IowaScaledEngineering/mss-crossover/mech/crossover-1x-blister-box v2.stl

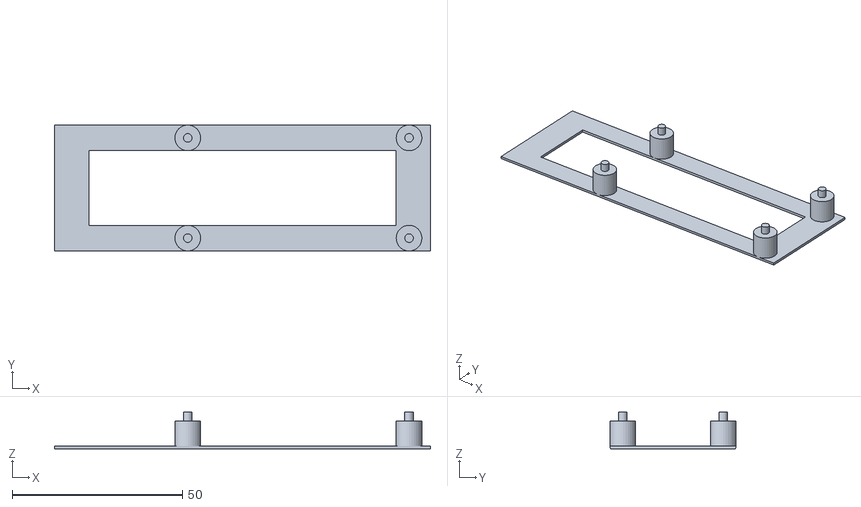
[picture p1: CAD file, 2024-08-07]
mech/crossover-1x-blister-box v2.stl
110.5 x 37.0 x 10.8
