IowaScaledEngineering/mss-crossover/pg/mss-crossover-array-v2.1-066dc88/mss-crossover.pdf

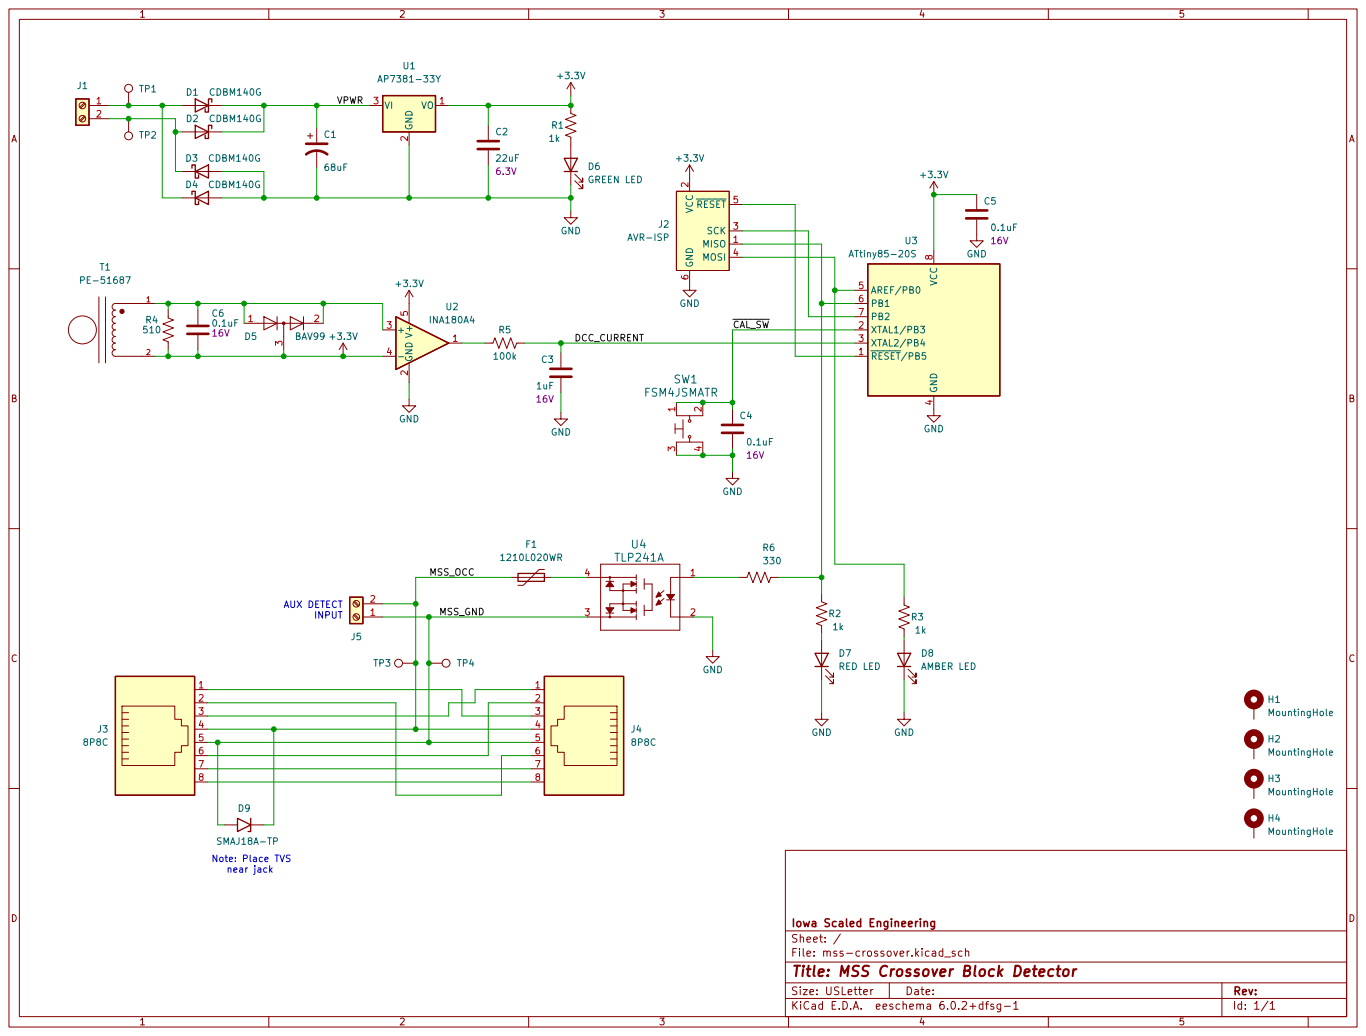
[picture p2: page 1]

2 SCK 3 MOSI 4 ~{RESET} 5 GND

INPUT Note: Place TVS
1k D9 SMAJ18A-TP

Iowa Scaled Engineering
File: mss-crossover.kicad_sch Sheet: /
Id: 1/1 Title: MSS Crossover Block Detector
