IowaScaledEngineering/mss-crossover/pg/mss-crossover-v2.0-48896b5/mss-crossover.pdf

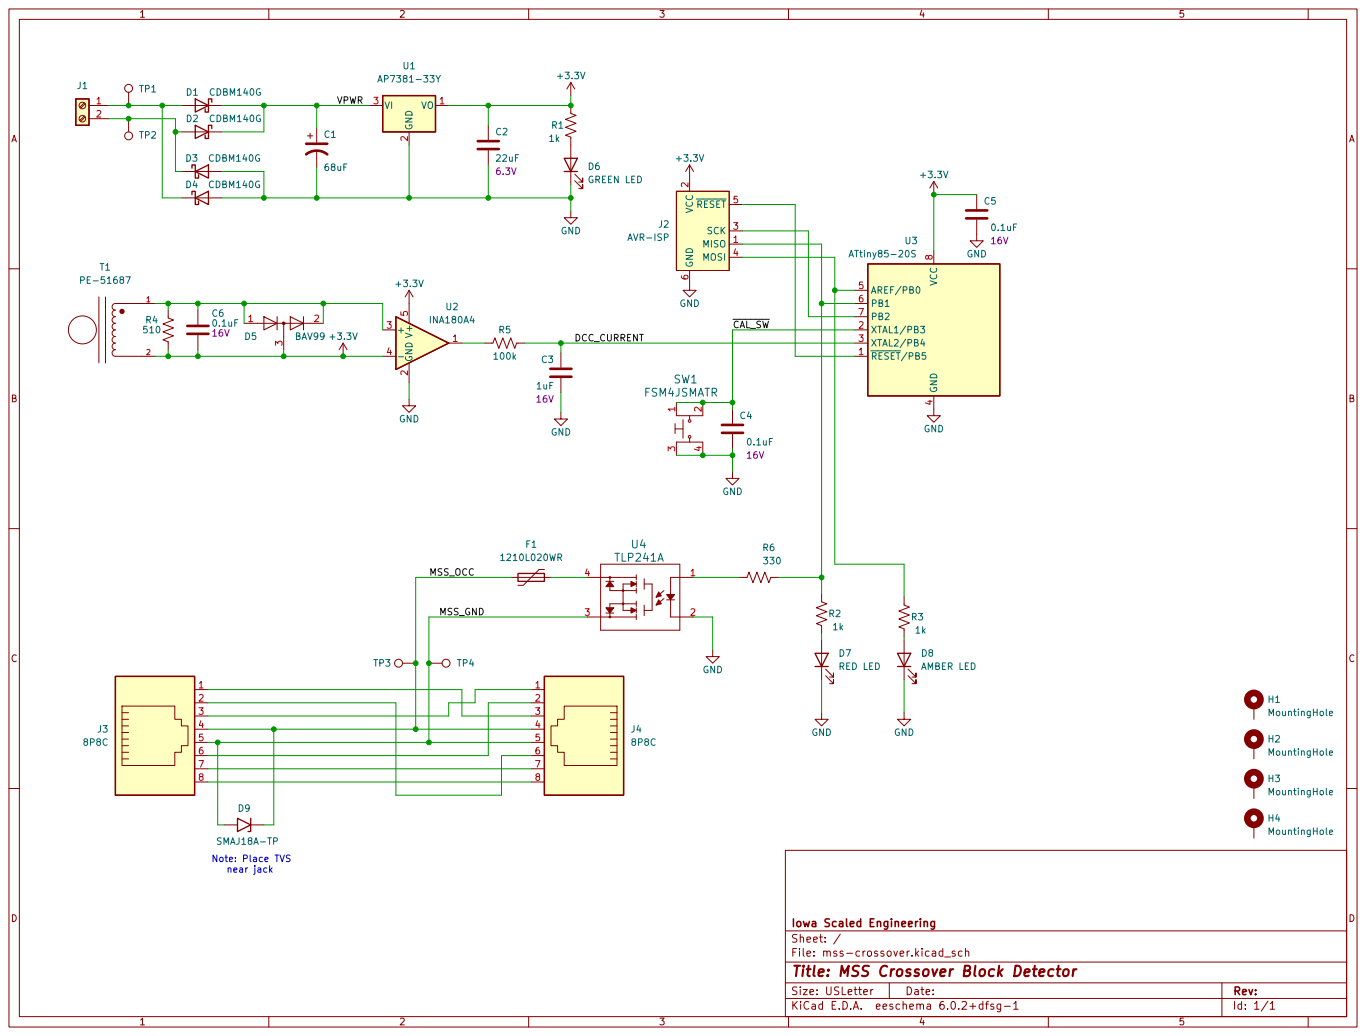
[picture p3: page 1]

2 SCK 3 MOSI 4 ~{RESET} 5 GND

Iowa Scaled Engineering GND

File: mss-crossover.kicad_sch Sheet: /
Id: 1/1 Title: MSS Crossover Block Detector
