IowaScaledEngineering/mss-crossover/pg/mss-crossover-v1.3-59efc50/mss-crossover.pdf

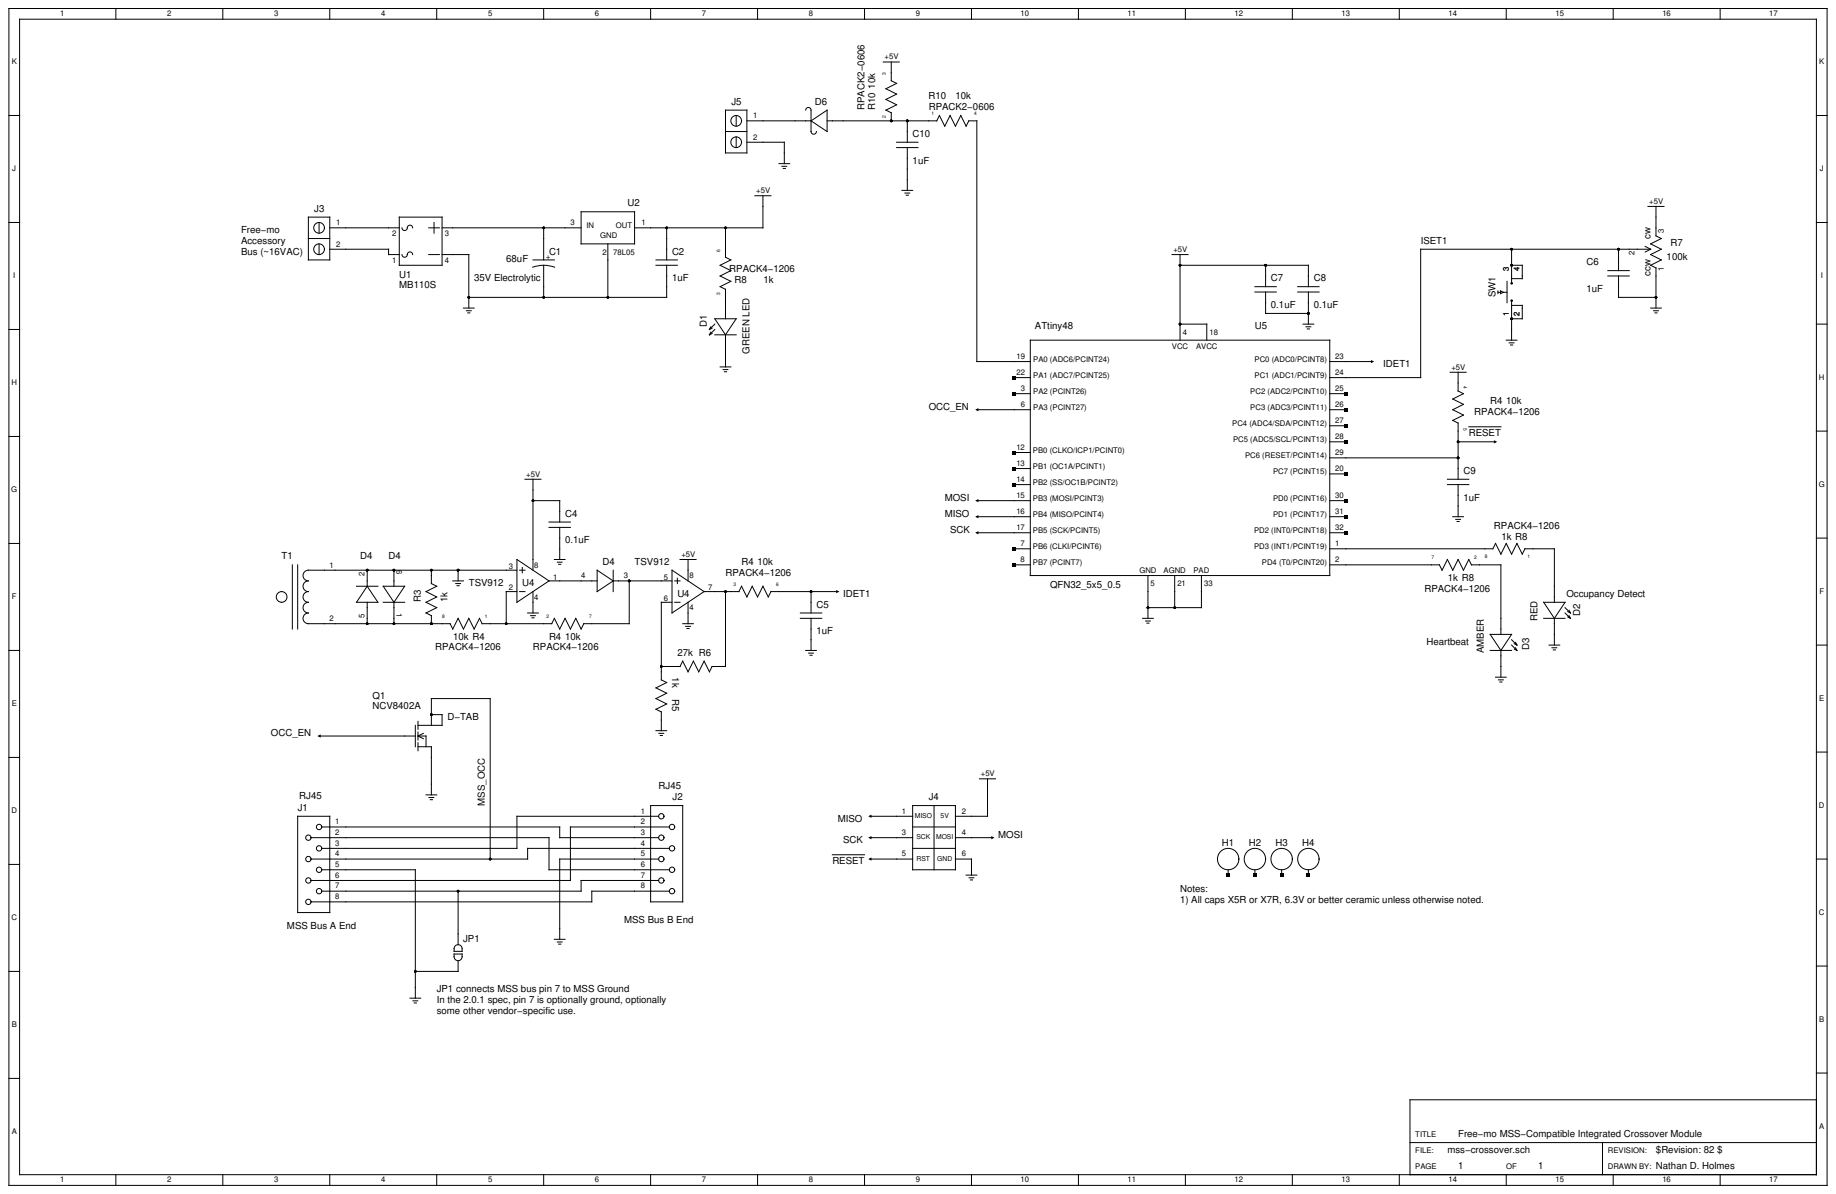
[picture p4: page 1]

Notes:
1) All caps X5R or X7R, 6.3V or better ceramic unless otherwise noted.

JP1 connects MSS bus pin 7 to MSS Ground
In the 2.0.1 spec, pin 7 is optionally ground, optionally
some other vendor−specific use.

Free−mo MSS−Compatible Integrated Crossover Module
mss−crossover.sch
