IowaScaledEngineering/mss-crossover/pg/mss-crossover-v1.2-c0949ba/mss-crossover-pcb.pdf

# mss-crossover.pcb

# 1. Table of Contents (This Page) Created on Thu Jun 1 21:09:37 2017

# 2. component 3. solder 4. outline 5. plated-drill 6. unplated-drill 7. componentmask 8. soldermask 9. topsilk 10. bottomsilk 11. toppaste 12. topassembly 13. bottomassembly 14. fab

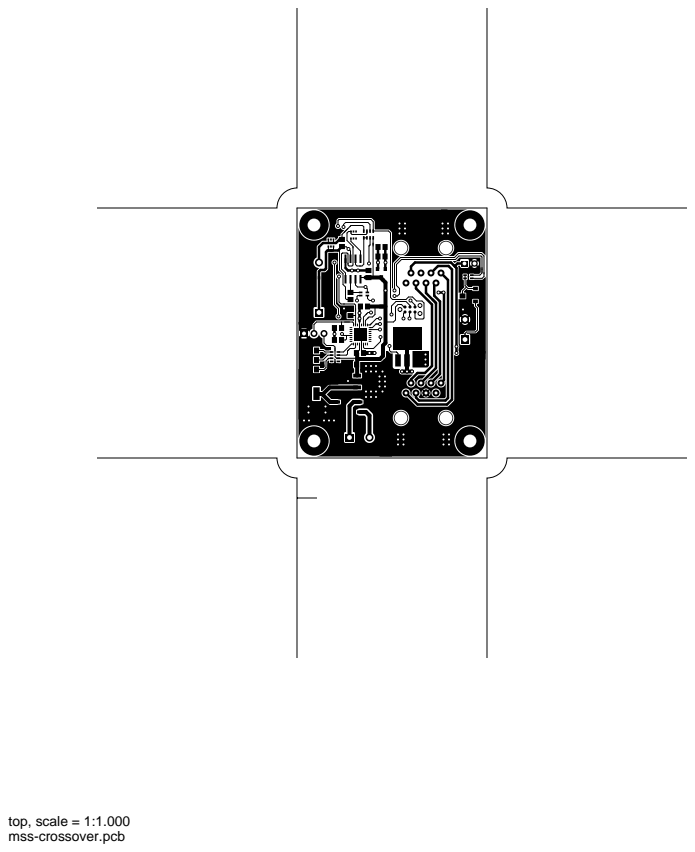
[picture p5: page 2]
top, scale = 1:1.000

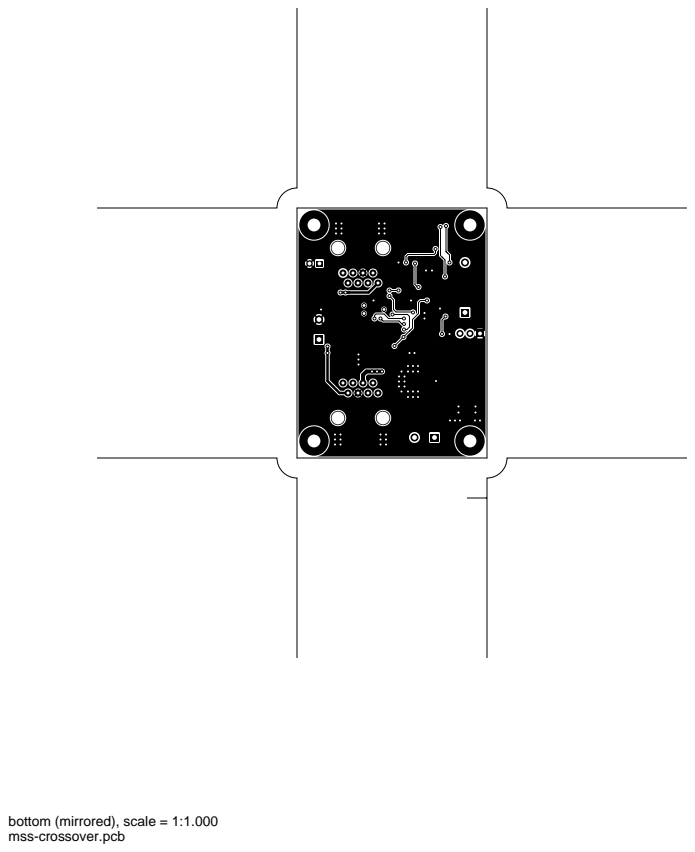
[picture p6: page 3]

bottom (mirrored), scale = 1:1.000

outline, scale = 1:1.000

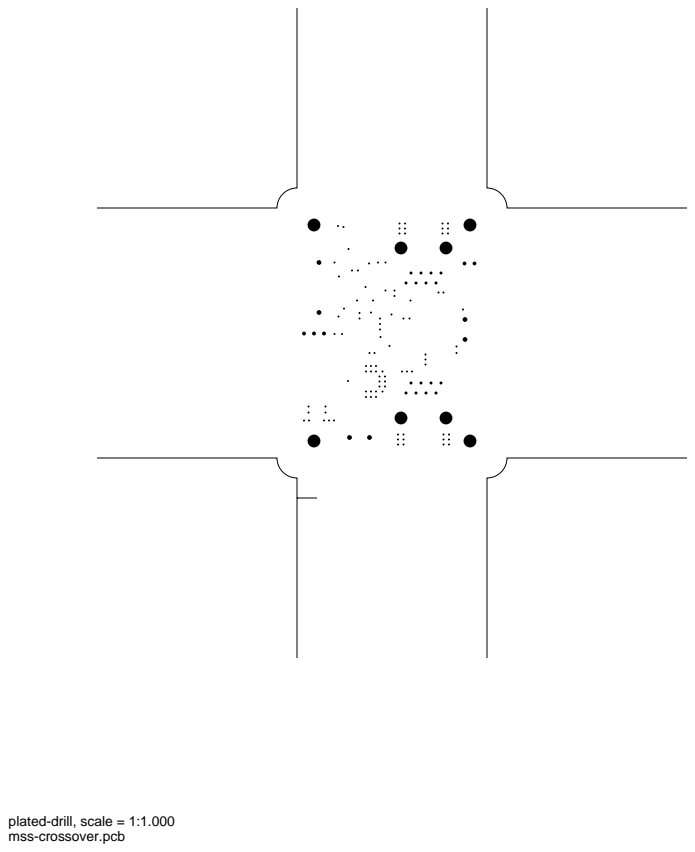
[picture p7: page 5]

plated-drill, scale = 1:1.000

unplated-drill, scale = 1:1.000

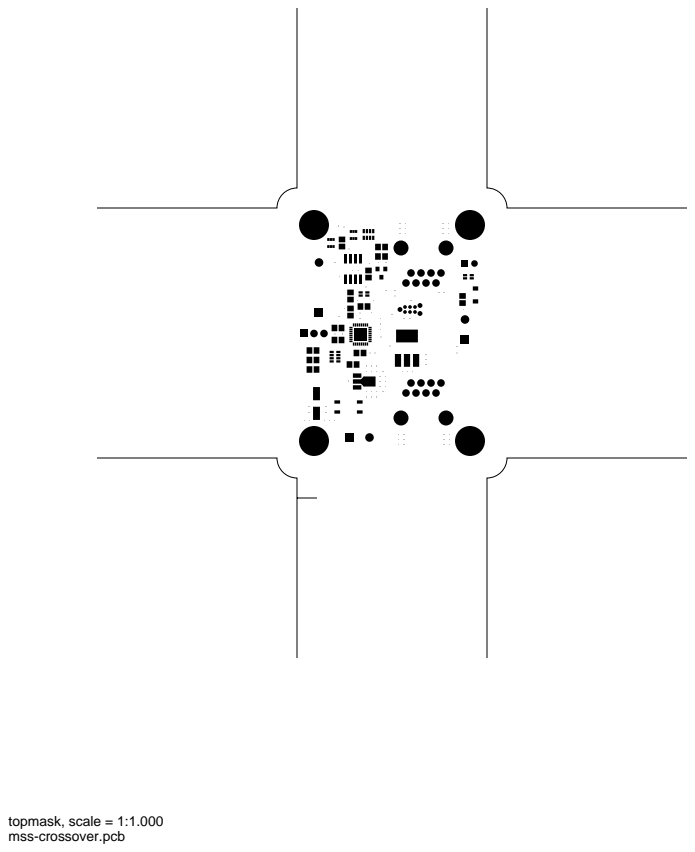
[picture p8: page 7]
topmask, scale = 1:1.000

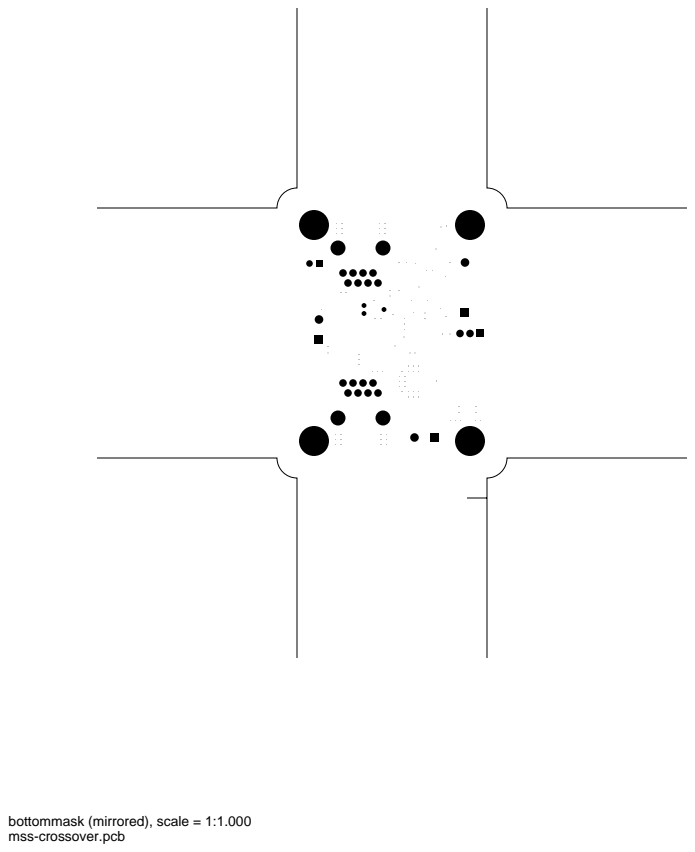
[picture p9: page 8]

bottommask (mirrored), scale = 1:1.000

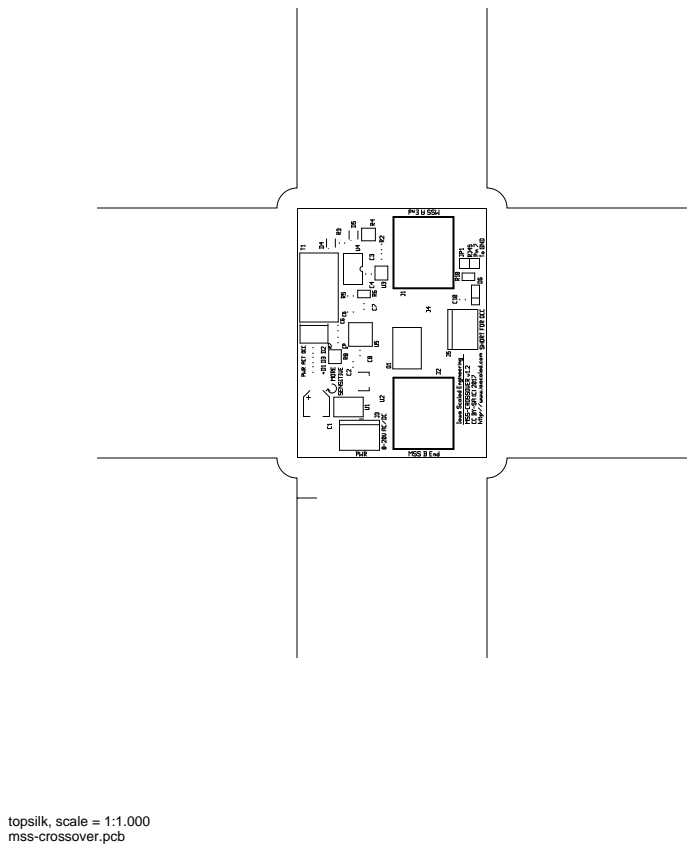
[picture p10: page 9]
topsilk, scale = 1:1.000

bottomsilk (mirrored), scale = 1:1.000

toppaste, scale = 1:1.000

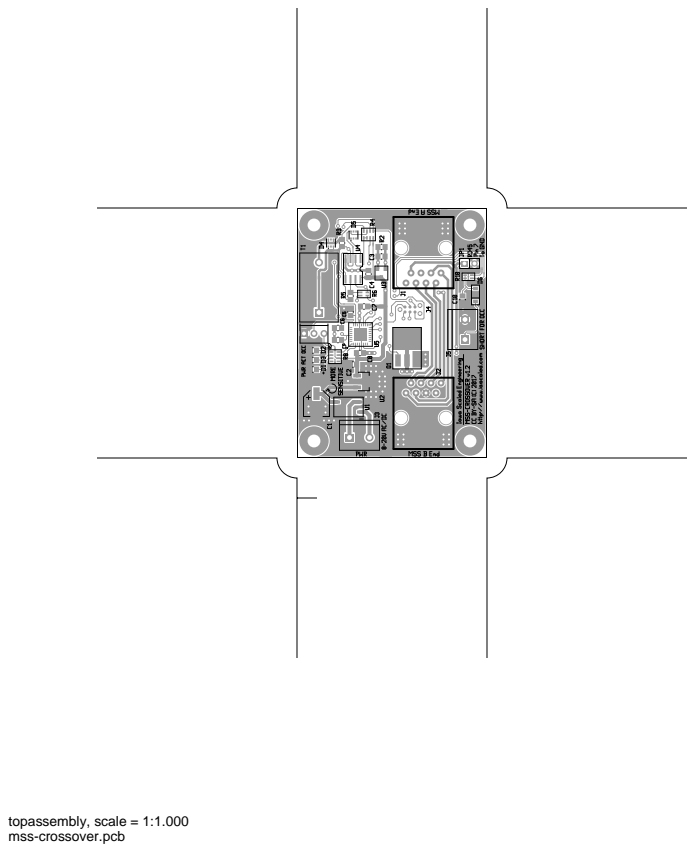
[picture p11: page 12]
topassembly, scale = 1:1.000

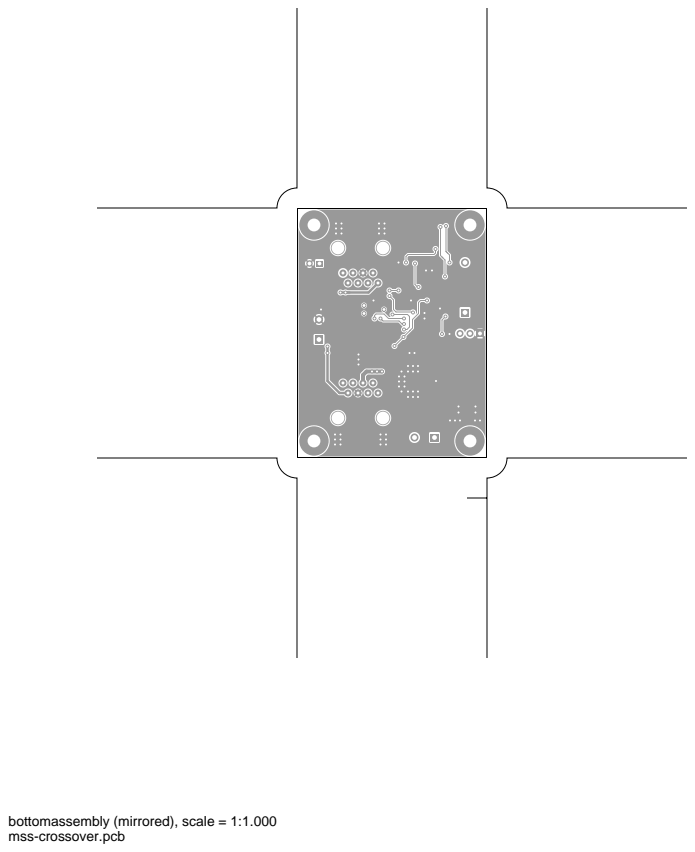
[picture p12: page 13]

bottomassembly (mirrored), scale = 1:1.000

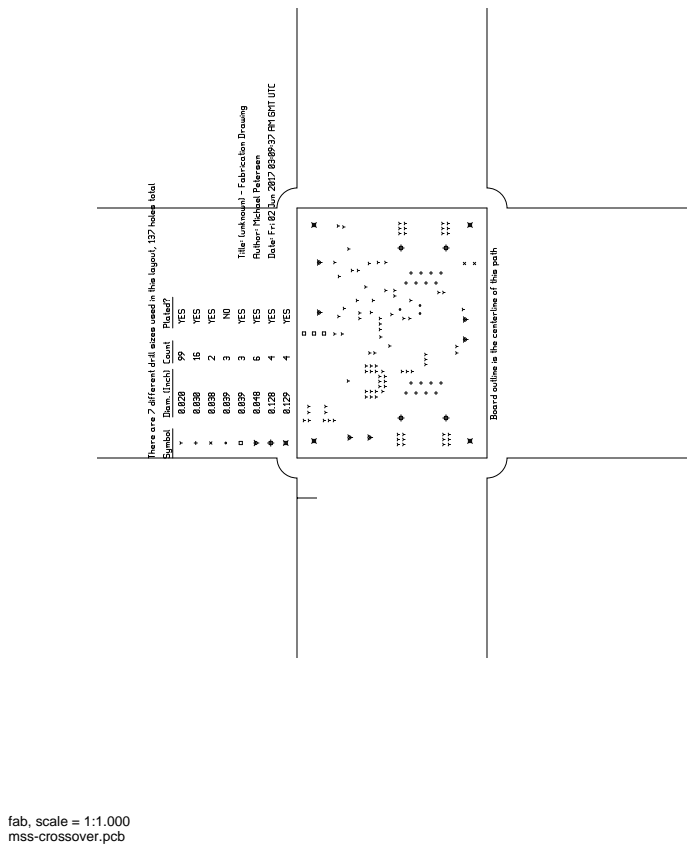
[picture p13: page 14]
fab, scale = 1:1.000
