IowaScaledEngineering/mss-crossover/pg/mss-crossover-v1.2-c0949ba/mss-crossover.pdf

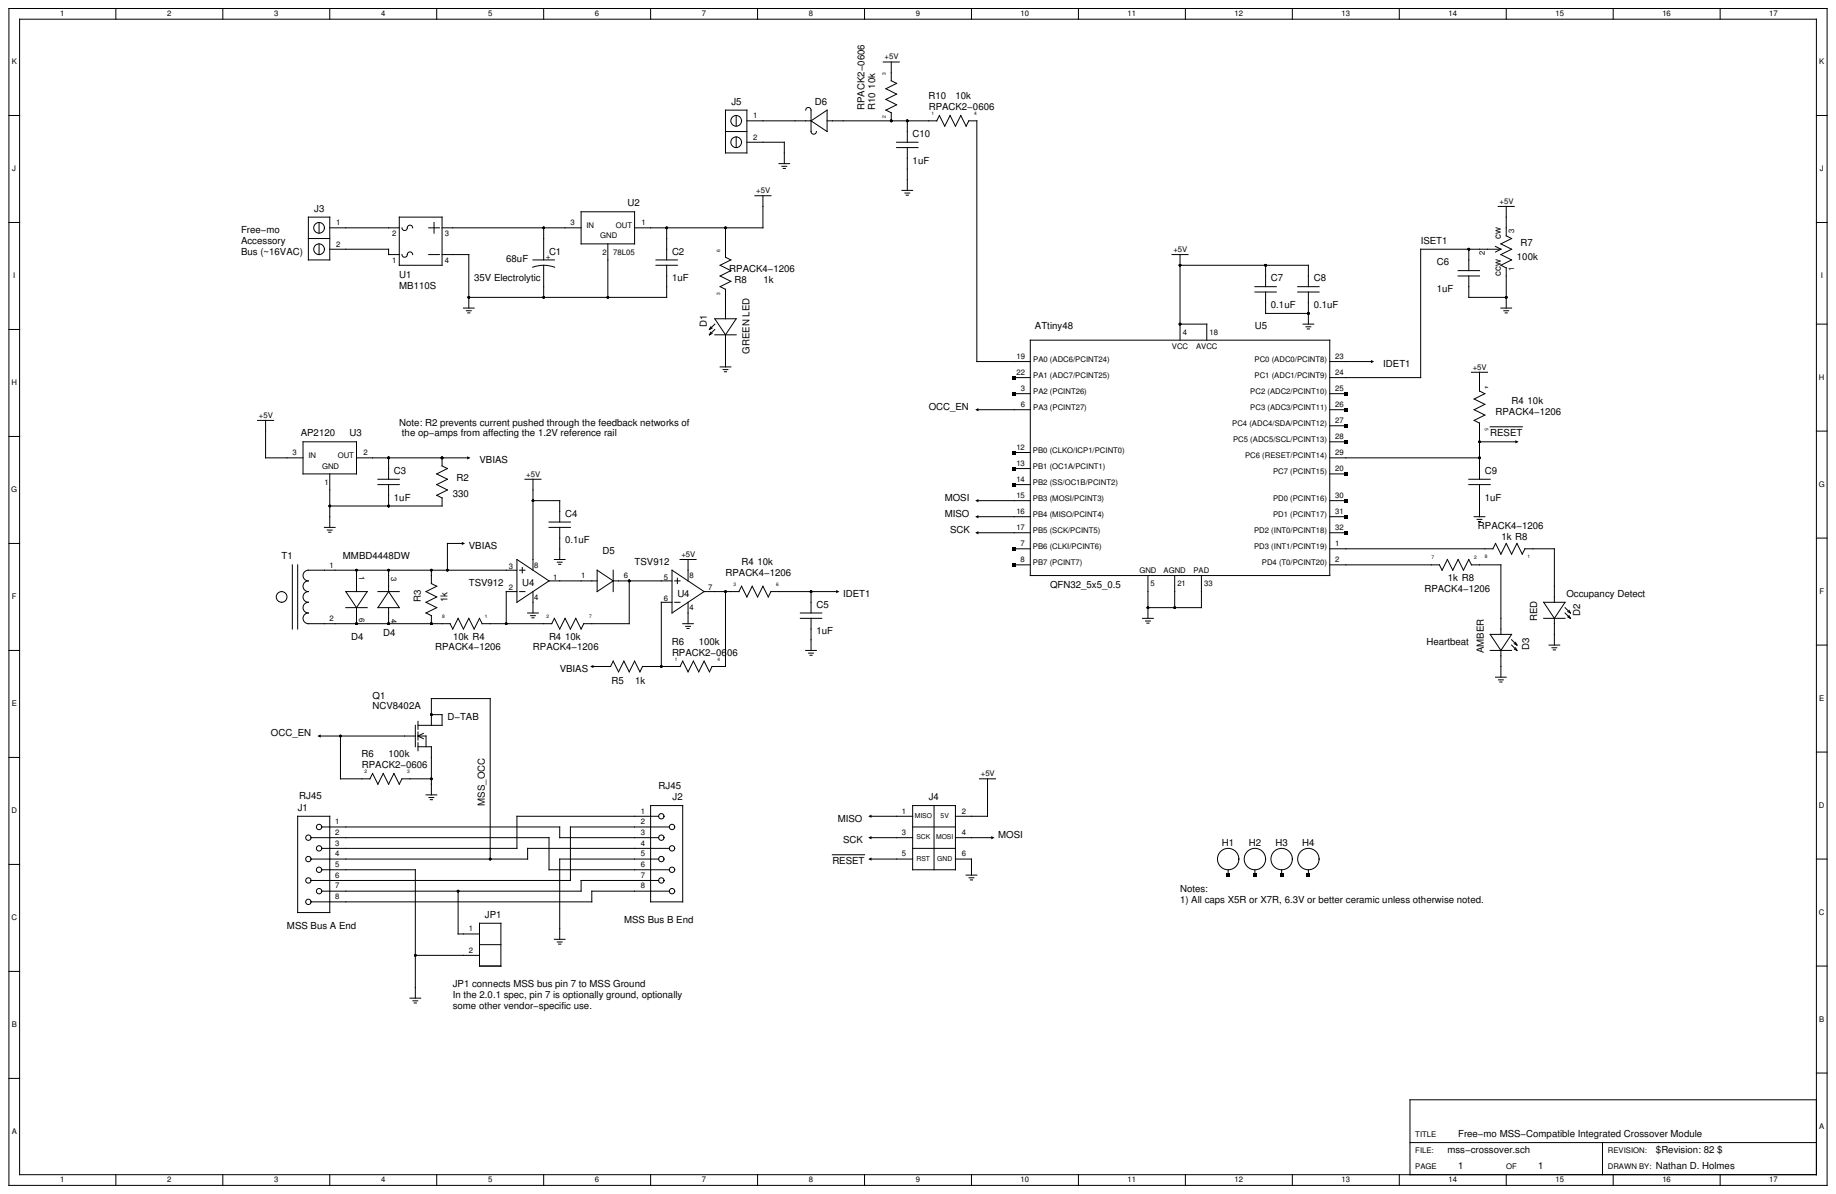
[picture p14: page 1]

Note: R2 prevents current pushed through the feedback networks of
the op−amps from affecting the 1.2V reference rail

Notes:
1) All caps X5R or X7R, 6.3V or better ceramic unless otherwise noted.

some other vendor−specific use. | JP1

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

Free−mo MSS−Compatible Integrated Crossover Module
mss−crossover.sch
