IowaScaledEngineering/mss-crossover/pg/mss-crossover-v1.0-68059cf/mss-crossover-pcb.pdf

# mss-crossover.pcb

# 1. Table of Contents (This Page) Created on Tue Nov 3 13:28:19 2015

# 2. component 3. solder 4. outline 5. plated-drill 6. unplated-drill 7. componentmask 8. soldermask 9. topsilk 10. bottomsilk 11. toppaste 12. topassembly 13. bottomassembly 14. fab

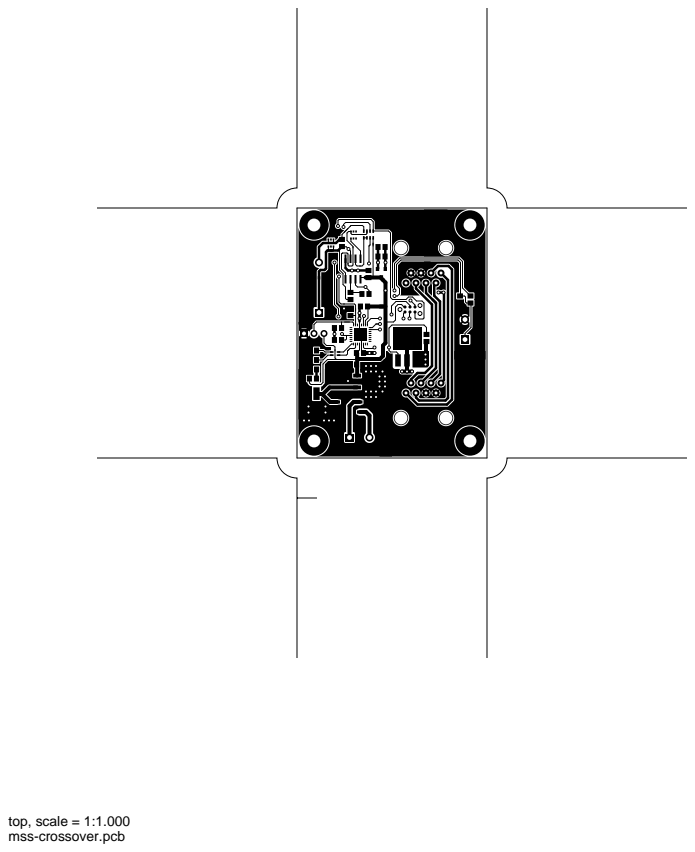
[picture p18: page 2]
top, scale = 1:1.000

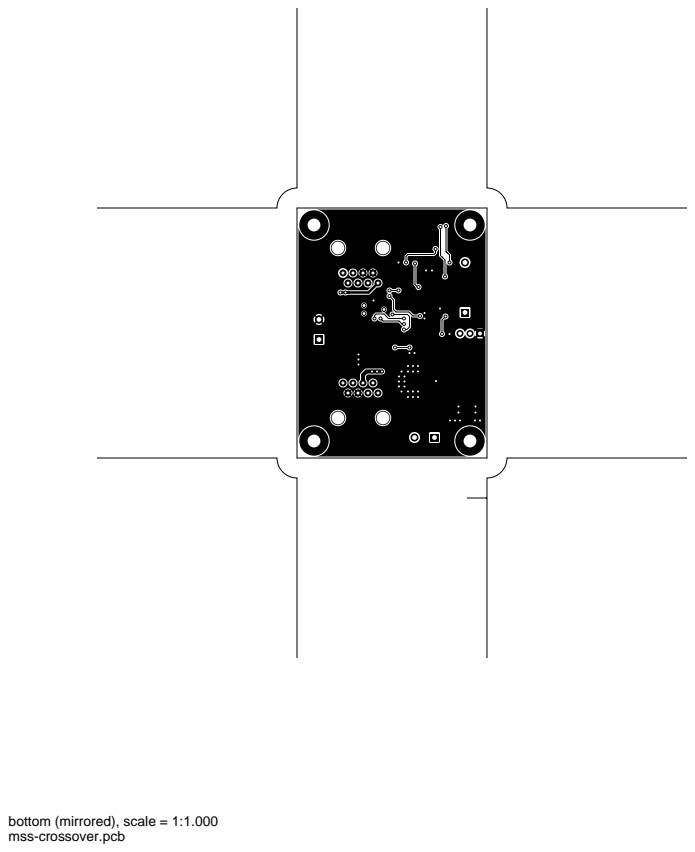
[picture p19: page 3]

bottom (mirrored), scale = 1:1.000

outline, scale = 1:1.000

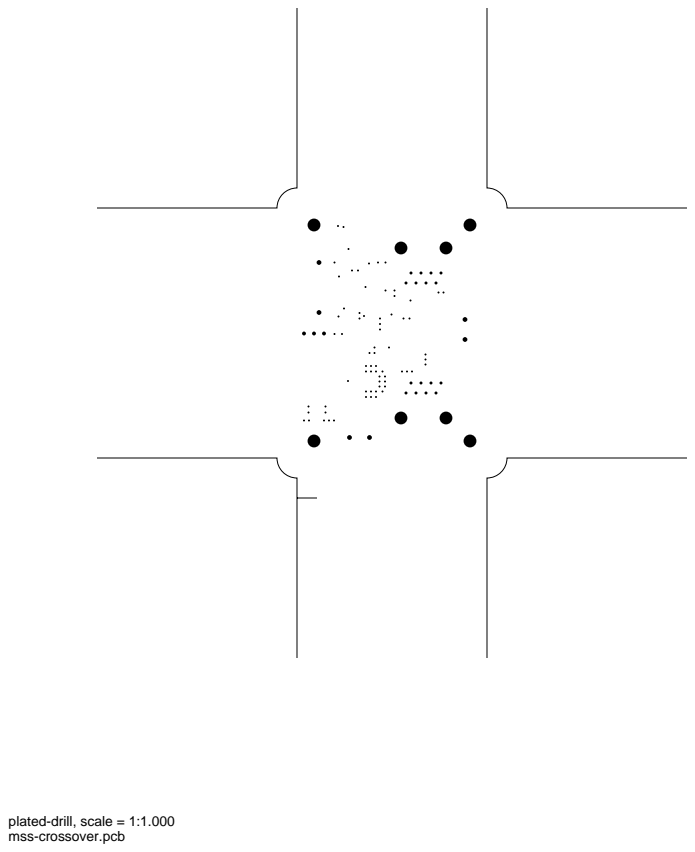
[picture p20: page 5]

plated-drill, scale = 1:1.000

unplated-drill, scale = 1:1.000

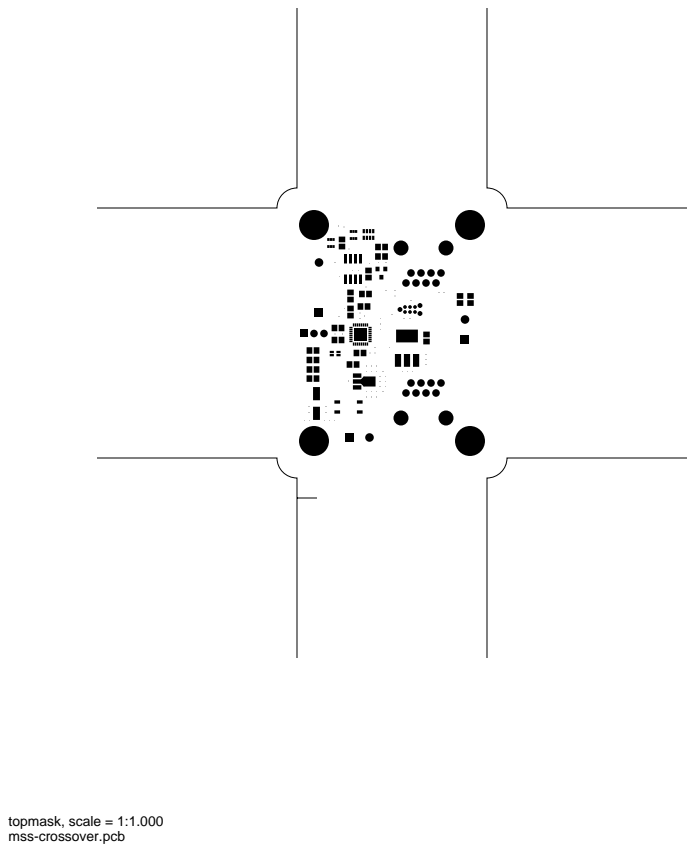
[picture p21: page 7]
topmask, scale = 1:1.000

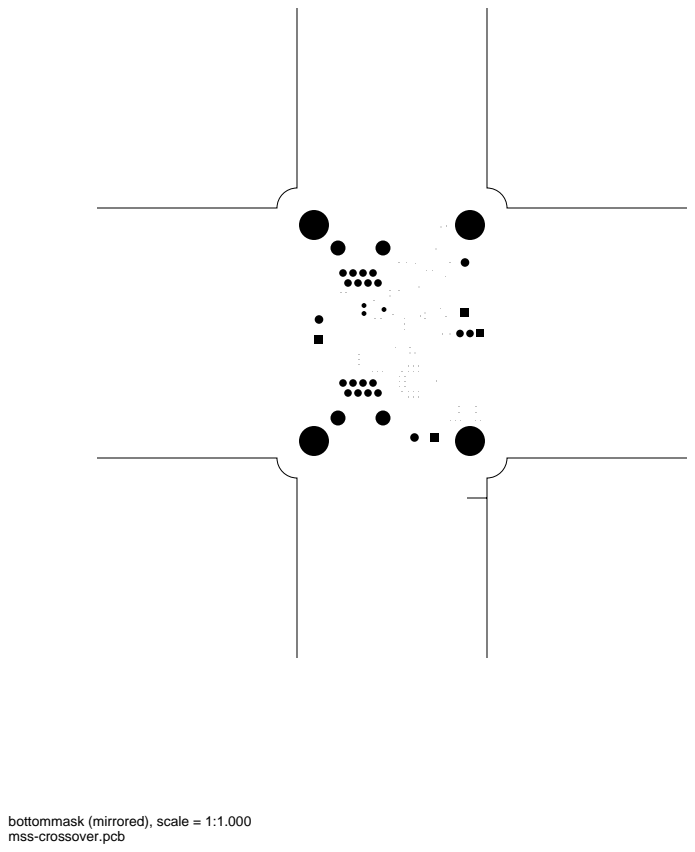
[picture p22: page 8]

bottommask (mirrored), scale = 1:1.000

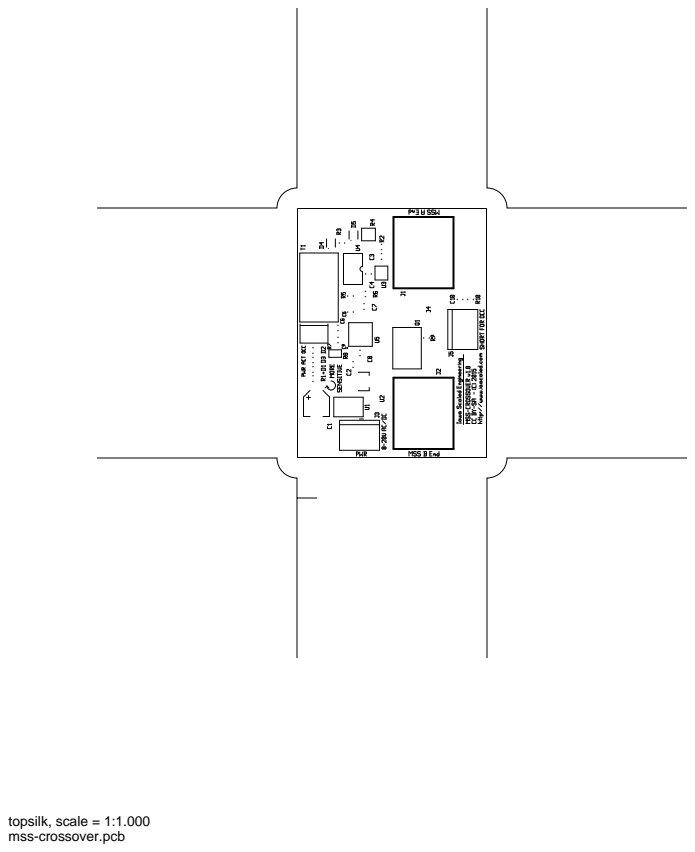
[picture p23: page 9]
topsilk, scale = 1:1.000

bottomsilk (mirrored), scale = 1:1.000

toppaste, scale = 1:1.000

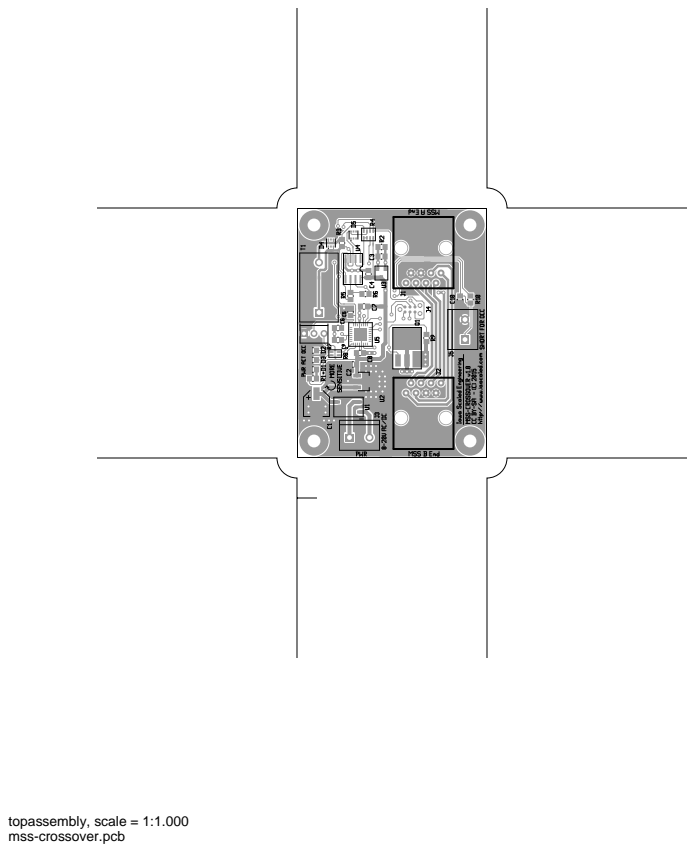
[picture p24: page 12]
topassembly, scale = 1:1.000

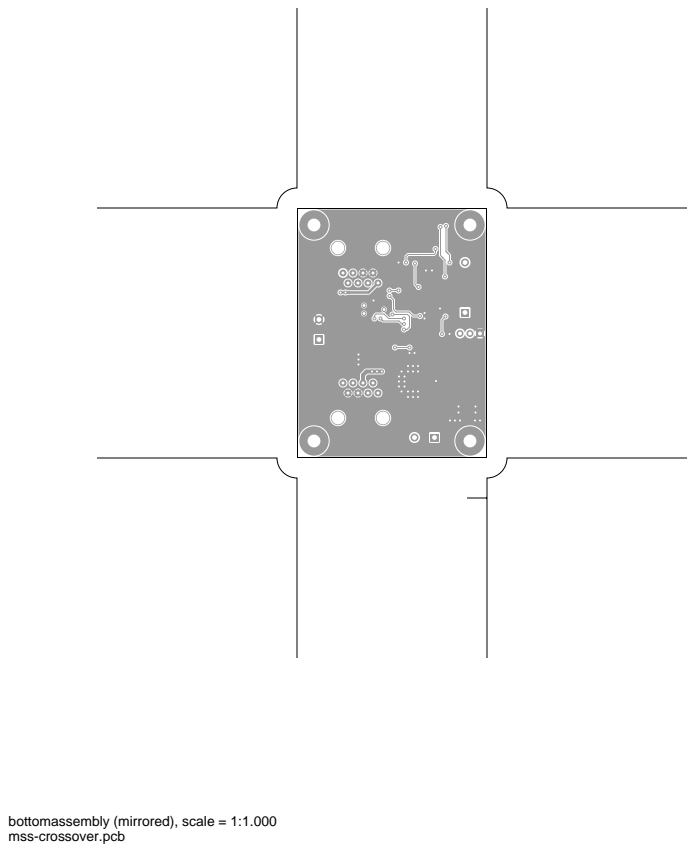
[picture p25: page 13]

bottomassembly (mirrored), scale = 1:1.000

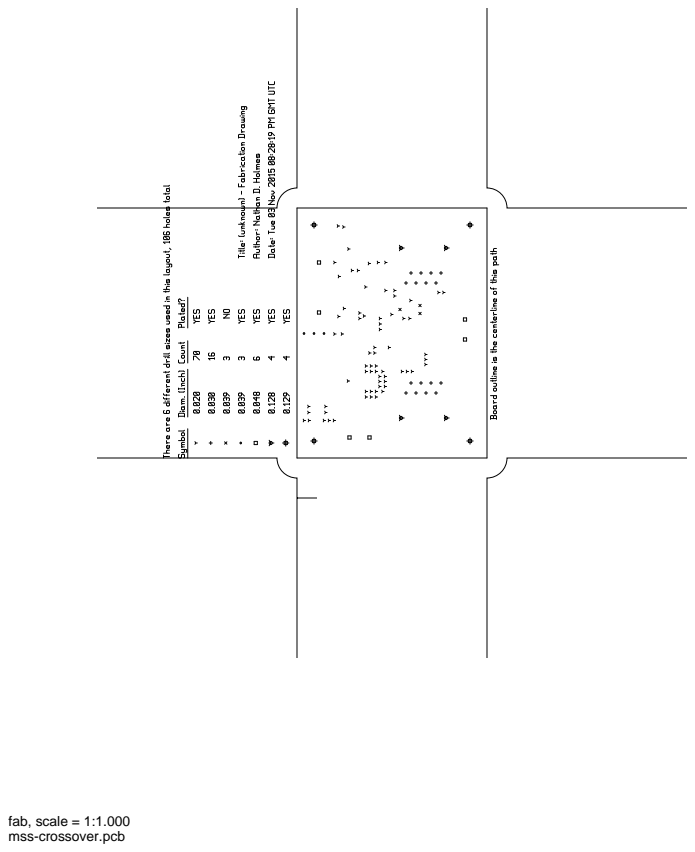
[picture p26: page 14]
fab, scale = 1:1.000
