IowaScaledEngineering/mss-crossover/kicad/mss-crossover/mss-crossover.kicad_pcb

## KiCad design kicad/mss-crossover/mss-crossover.kicad_pcb (2024-05-26)

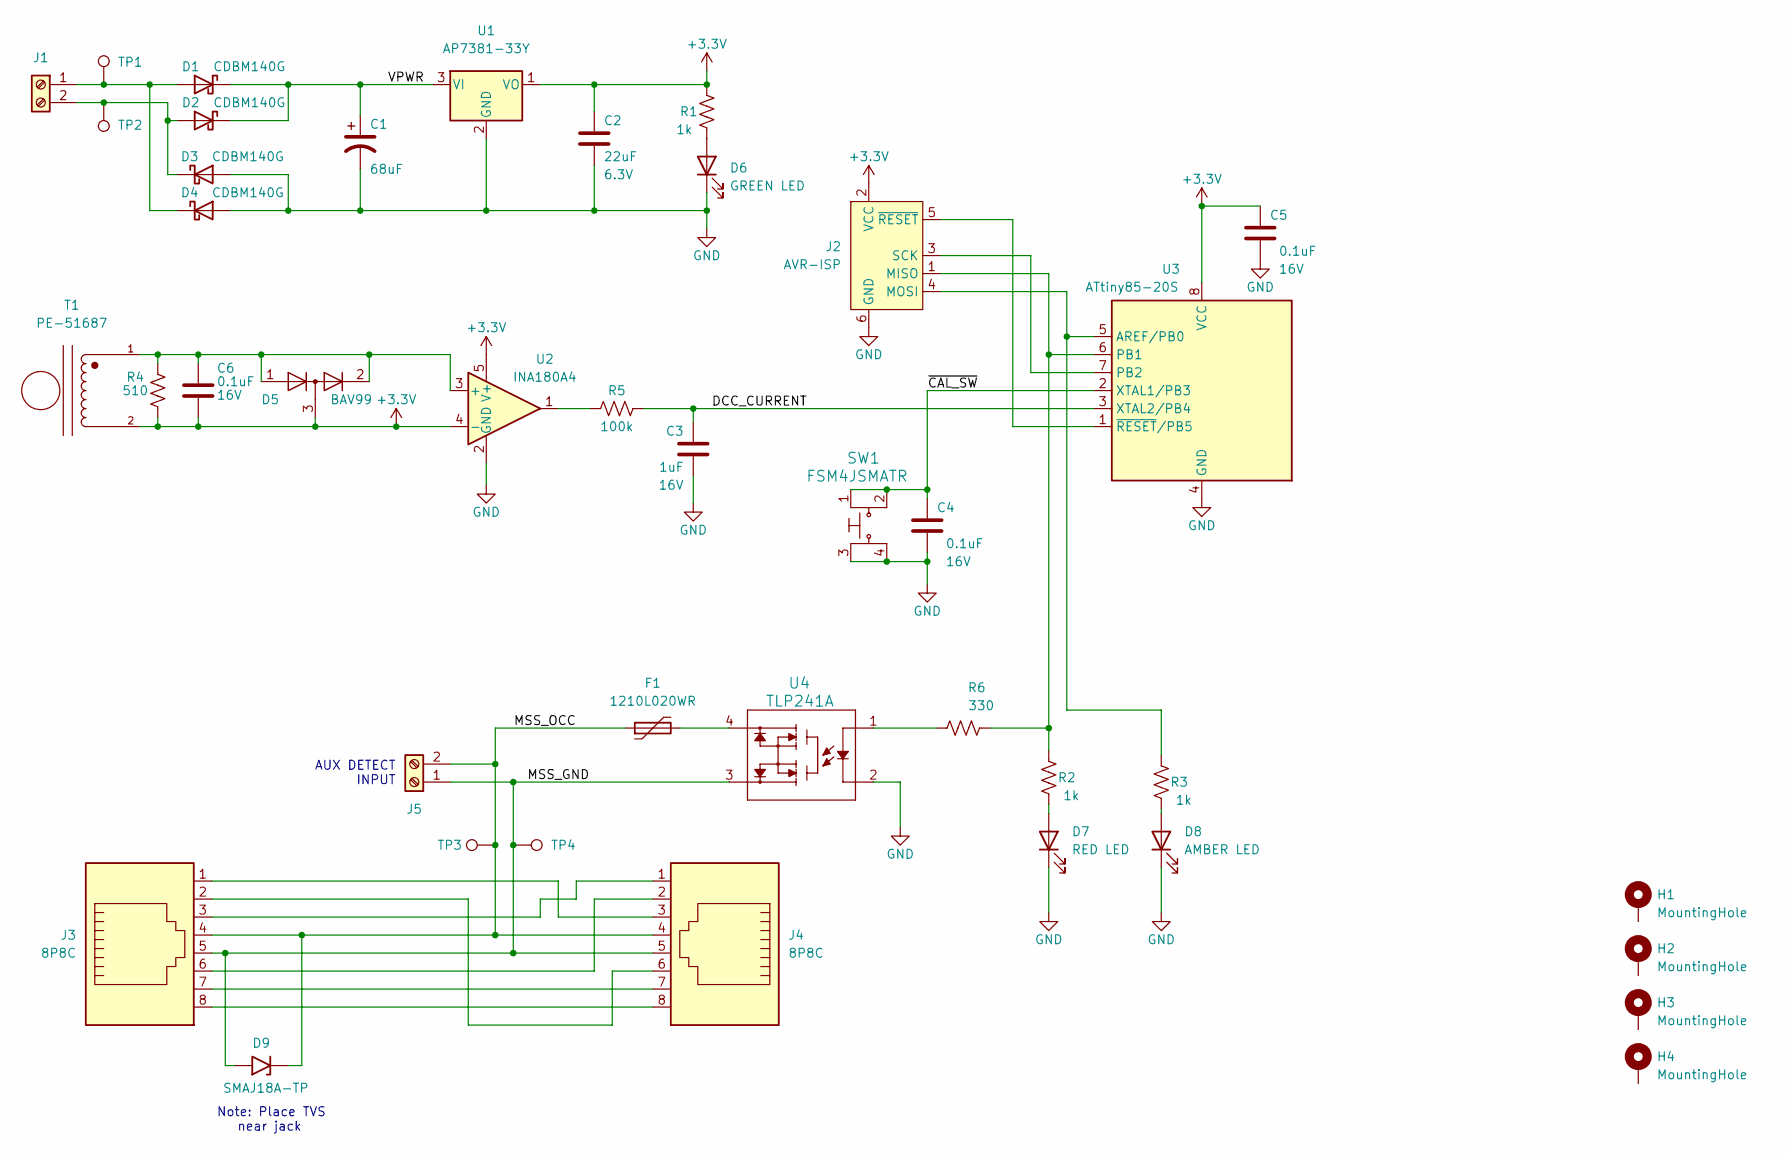
[picture p27: schematic mss-crossover.kicad_sch, MSS Crossover Block Detector]

Parts:
C1: 68uF; CP_Elec_6.3x5.8
C2: 22uF; C_0805_2012Metric; Voltage 6.3V
C3: 1uF; C_0805_2012Metric; Voltage 16V
C4, C5, C6: 0.1uF; C_0805_2012Metric; Voltage 16V
D1, D2, D3, D4: CDBM140G; SOD-123T
D5: BAV99; SOT-23
D6: GREEN LED; LED_0805_2012Metric
D7: RED LED; LED_0805_2012Metric
D8: AMBER LED; LED_0805_2012Metric
D9: SMAJ18A-TP; D_SMA
F1: 1210L020WR; R_1210_3225Metric
H1, H2, H3, H4: MountingHole; MountingHole_3.2mm_M3_Pad
J1, J5: Screw_Terminal_01x02; TerminalBlock_RND_205-00012_1x02_P5.00mm_Horizontal
J2: AVR-ISP; Tag-Connect_TC2030-IDC-NL_2x03_P1.27mm_Vertical
J3, J4: 8P8C; RJ45_Amphenol_54602-x08_Horizontal
R1, R2, R3: 1k; R_0805_2012Metric
R4: 510; R_0805_2012Metric
R5: 100k; R_0805_2012Metric
R6: 330; R_0805_2012Metric
SW1: FSM4JSMATR; TE_FSM4JSMA; MPN FSM4JSMATR; Digi-Key_PN 450-1759-1-ND
T1: PE-51687; XFMR_PE-51687
TP1, TP2, TP3, TP4: TestPoint; TestPoint_Pad_D2.0mm
U1: AP7381-33Y; SOT-89-3
U2: INA180A4; SOT-23-5
U3: ATtiny85-20S; ATMEL_SO8_DUAL
U4: TLP241A; 11-5B201S_TOS

Connections:
+3.3V: C2.1, C5.1, C6.2, D5.3 (K), J2.2 (VCC), R1.2, R4.1, T1.2, U1.1 (VO), U2.4 (-), U2.5 (V+), U3.8 (VCC)
/DCC_CURRENT: C3.1, R5.1, U3.3 (XTAL2/PB4)
/MSS_GND: D9.2 (A2), J3.5, J4.5, J5.1, TP4.1, U4.3
/MSS_OCC: D9.1 (A1), F1.1, J3.4, J4.4, J5.2, TP3.1
/VPWR: C1.1, D1.1 (K), D2.1 (K), U1.3 (VI)
/~CAL_SW: C4.1, SW1.1, SW1.2, U3.2 (XTAL1/PB3)
GND: C1.2, C2.2, C3.2, C4.2, C5.2, D3.2 (A), D4.2 (A), D6.1 (K), D7.1 (K), D8.1 (K), J2.6 (GND), SW1.3, SW1.4, U1.2 (GND), U2.2 (GND), U3.4 (GND), U4.2
unnamed: C6.1, D5.1 (K), D5.2 (A), R4.2, T1.1, U2.3 (+)
unnamed: D1.2 (A), D4.1 (K), J1.1, TP1.1
unnamed: D2.2 (A), D3.1 (K), J1.2, TP2.1
unnamed: D6.2 (A), R1.1
unnamed: D7.2 (A), R2.2
unnamed: D8.2 (A), R3.2
unnamed: F1.2, U4.4
unnamed: J2.1 (MISO), R2.1, R6.2, U3.6 (PB1)
unnamed: J2.3 (SCK), U3.7 (PB2)
unnamed: J2.4 (MOSI), R3.1, U3.5 (AREF/PB0)
unnamed: J2.5 (~RESET), U3.1 (~RESET/PB5)
unnamed: J3.1, J4.3
unnamed: J3.2, J4.6
unnamed: J3.3, J4.1
unnamed: J3.6, J4.2
unnamed: J3.7, J4.7
unnamed: J3.8, J4.8
unnamed: R5.2, U2.1
unnamed: R6.1, U4.1

Notes on the sheet:
AUX DETECT INPUT
Note: Place TVS near jack

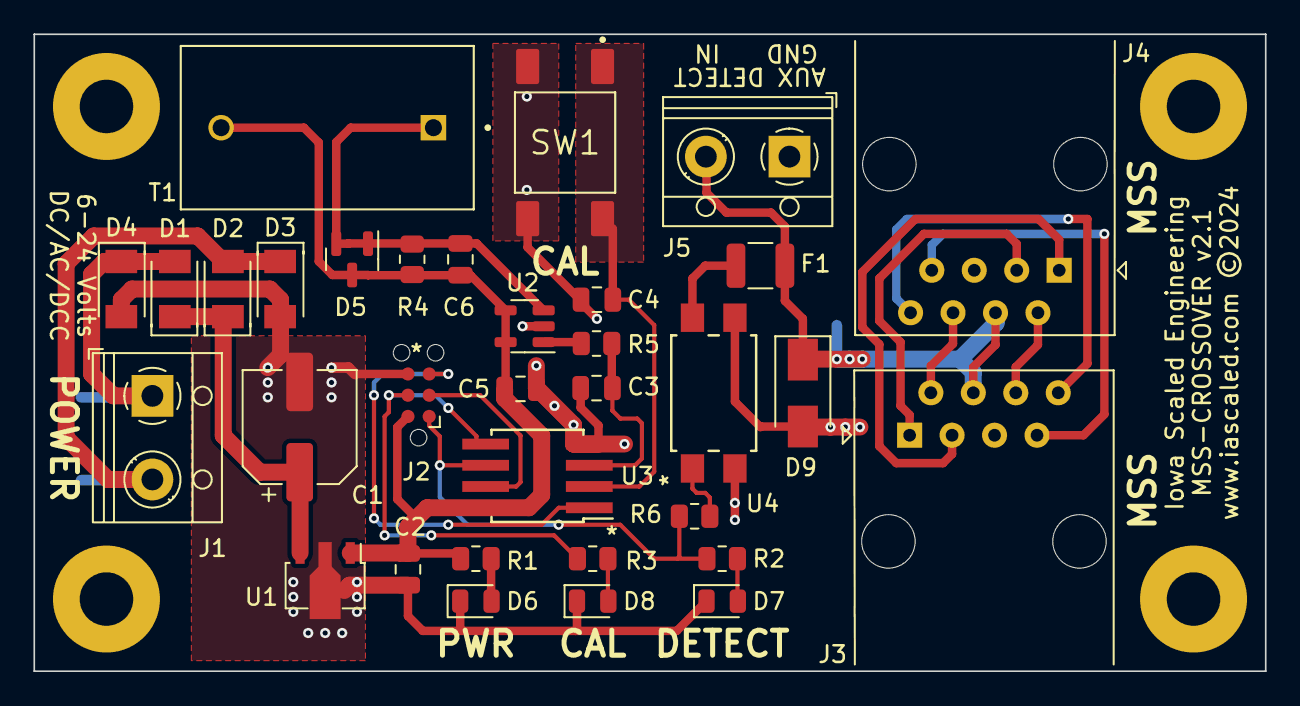
[picture p28: board mss-crossover.kicad_pcb from above]

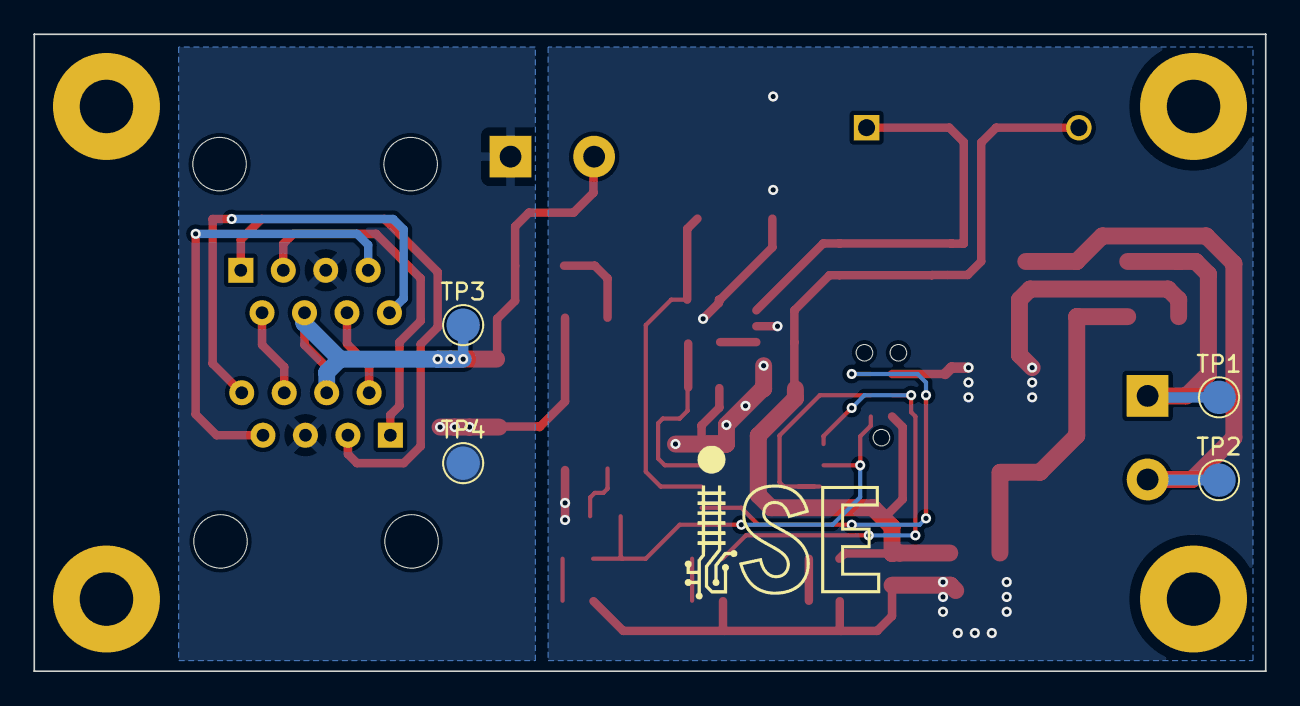
[picture p29: board mss-crossover.kicad_pcb from below]

Board: 2 copper layers, 73.7 x 38.1 mm, 41 parts (4 on the bottom side), 26 nets.
