IowaScaledEngineering/mss-crossover/(commit log)

2015-10-14 Initial cut of mss-crossover module
    [mss-crossover.sch]
2015-10-14 Update text on schematic
    [mss-crossover.sch]
2015-10-27 Change micro, add occupancy input (for turnouts, etc.) and clean up a few things
    [mss-crossover.pcb, mss-crossover.sch]
2015-10-28 First cut of "finished" pcb
    [mss-crossover.pcb, mss-crossover.sch]
2015-10-28 Update occupancy input pullup resistor value
    [mss-crossover.sch]
2015-10-28 Twiddling with refdes cleanup and other last minute stuff
    [mss-crossover.pcb]
2015-11-02 Fix a few things from Michael's review.
    [mss-crossover.pcb, mss-crossover.sch]
2015-11-02 Remove a tiny metal sliver
    [mss-crossover.pcb]
2015-11-03 Add sensitivity adjustment guide text
    [mss-crossover.pcb]
2015-11-03 PG v1.0
    [mss-crossover.bottom.gbr, mss-crossover.bottommask.gbr, mss-crossover.bottompaste.gbr, mss-crossover.bottomsilk.gbr, mss-crossover.fab.gbr, mss-crossover.outline.gbr, mss-crossover.top.gbr, mss-crossover.topmask.gbr]
2015-11-21 Removed extraneous wires
2015-11-22 Reverse light pin definitions
2015-11-24 Suggestions from Gregg F: - clamp on the aux input - jumper MSS bus 7 to MSS ground, allowing for use as an alternate function
    [mss-crossover.sch]
2015-11-24 Modify schematic to add comment Modify PCB to add JP1 and Q2
    [mss-crossover.pcb, mss-crossover.sch]
2015-11-25 Move R10 to the back side of the protection fet to inhibit backfeeding into the power rail
    [mss-crossover.pcb, mss-crossover.sch]
2016-03-06 Make the 1Hz blink actually 1Hz
2016-09-14 Change out input protection circuit for a new one.
    [mss-crossover.pcb, mss-crossover.sch]
2016-09-14 Fix a bit of missing metal plane in lower right
    [mss-crossover.pcb]
2016-09-14 Combine R6/R9 into 100k 2-pack
    [mss-crossover.pcb, mss-crossover.sch]
2016-09-17 Add crossover v1.1
    [mss-crossover.bottom.gbr, mss-crossover.bottommask.gbr, mss-crossover.bottompaste.gbr, mss-crossover.bottomsilk.gbr, mss-crossover.fab.gbr, mss-crossover.outline.gbr, mss-crossover.top.gbr, mss-crossover.topmask.gbr]
2017-06-02 Decreased solder paste aperature on the QFN32 footprint. Bumped rev to 1.2 Changed (C) to 2017
    [mss-crossover.pcb]
2017-06-02 Decreased QFN paste aperture
    [mss-crossover.bottom.gbr, mss-crossover.bottommask.gbr, mss-crossover.bottompaste.gbr, mss-crossover.bottomsilk.gbr, mss-crossover.fab.gbr, mss-crossover.outline.gbr, mss-crossover.top.gbr, mss-crossover.topmask.gbr]
2018-12-13 Potential v1.3 candidate - improved detector, some other simplifications
    [mss-crossover.pcb, mss-crossover.sch]
2018-12-27 Add pushbutton for DCC current auto-set
    [mss-crossover.pcb, mss-crossover.sch]
2018-12-30 Sent to Seeed
    [mss-crossover.bottom.gbr, mss-crossover.bottommask.gbr, mss-crossover.bottompaste.gbr, mss-crossover.bottomsilk.gbr, mss-crossover.fab.gbr, mss-crossover.outline.gbr, mss-crossover.top.gbr, mss-crossover.topmask.gbr]
2019-01-14 Fix slot attributes
    [mss-crossover.sch]
2019-04-04 New firmware for pushbutton current set
2019-04-04 Change the default current value to approximately what a 10k resistor comes up to on my test track
2024-02-15 New MSS-CROSSOVER v2.0 in Kicad
    [mss-crossover.kicad_pcb, mss-crossover.kicad_sch]
2024-02-17 Initial PCB layout complete on v2.0
    [mss-crossover.kicad_pcb, mss-crossover.kicad_sch]
2024-02-25 Updates per review
    [mss-crossover.kicad_pcb, mss-crossover.kicad_sch]
2024-04-03 Add test points
    [mss-crossover.kicad_pcb, mss-crossover.kicad_sch]
2024-04-03 Add 3d models
    [mss-crossover.kicad_pcb]
2024-04-06 Files for fab
    [mss-crossover-NPTH.drl, mss-crossover.drl, mss-crossover.gbl, mss-crossover.gbo, mss-crossover.gbp, mss-crossover.gbr, mss-crossover.gbs, mss-crossover.gm1]
2024-05-20 Update footprints for AVR to allow for both narrow/wide SO8s and footprint for CDBMs to allow for more paste
    [mss-crossover.kicad_pcb]
2024-05-21 Fix dual footprint SO8
    [mss-crossover.kicad_pcb]
2024-05-21 Update schematic footprints from PCB changes
    [mss-crossover.kicad_sch]
2024-05-21 Remove old source code and schematic/pcb files from geda
    [mss-crossover.pcb, mss-crossover.sch]
2024-05-21 Fix diode spacing to appease McFussyPants
    [mss-crossover.kicad_pcb]
2024-05-24 Add auxilliary detection terminal block
    [mss-crossover.kicad_pcb, mss-crossover.kicad_sch]
2024-05-26 Move transformer over and center switch to give more finger room Label aux detect terminals for GND and IN
    [mss-crossover.kicad_pcb]
2024-05-29 Add v4.1 array
    [mss-crossover-array.kicad_pcb]
2024-05-29 PG of mss-crossover v2.1 array
    [mss-crossover-array-NPTH.drl, mss-crossover-array.drl, mss-crossover-array.gbl, mss-crossover-array.gbo, mss-crossover-array.gbp, mss-crossover-array.gbr, mss-crossover-array.gbs, mss-crossover-array.gm1]
2024-08-07 Add crossover blister box insert stl/gcode
    [crossover-1x-blister-box v2.stl]
