IowaScaledEngineering/mss-crossover/(notices)

Notices in the files:
kicad/mss-crossover/mss-crossover.kicad_pcb:
www.iascaled.com ©2024
